ThomasChappe/S63_Arduino/(threads)

Thread 2 (2020-05-14):

S63

ticoraph, 2020-05-14:
Bonjour,
Je souhaiterai faire communiquer/sonner 2 téléphones s63 a cadran. Existe-t-il un vieil intercom qui permettrait de le faire? Pensez-vous que je puisse le faire avec 1 arduino? Merci et bravo pour votre projet.

ThomasChappe, 2020-05-15:
Bonjour,
Un intercom, j'en sais rien, encore faut-il se le procurer et arriver à le faire fonctionner !

Le plus simple avec un "Arduino" c'est de les faire communiquer en wifi, avec des ESP8266, qui sont des petites cartes très proches des Arduino, avec moins de pattes d'entrée/sortie mais avec du Wifi intégré :)

Du coup, avec un bon petit programme en mode client/serveur, ca devrait pouvoir se faire.

Sinon, avec des vrais Arduino, il faudrait un fil entre les deux, et avec une communication en mode "série", c'est possible aussi de les faire sonner l'un / l'autre.

Par contre, c'est relativement loin de ce projet. Je veux dire : la partie MP3 n'a plus d'intérêt et toute la gestion de la communication entre 2 téléphones n'est pas prévue dans ce programme.

Bonne continuation dans votre projet !

jojo-monk, 2020-12-18:
Bonjour,
Il y a quelques temps j'avais réalisé un petit lecteur MP3 piloté par s63 : [https://youtu.be/zMIlXWc8FFQ](url) j'avais aussi utilisé le site revolunet pour m'aider. A l'époque j'avais utilisé un raspberry pi0 malheureusement, le rpi0 (sans doute à cause de la chaleur) s'éteignait tout seul au bout d'un certain temps, de plus il met du temps à démarrer. J'aimerais améliorer mon projet en utilisant un arduino et un lecteur mp3 série comme celui-ci : [https://www.lextronic.fr/grove-lecteur-mp3-v3-107020069-56926.html](url) pour avoir une sortie jack, car je ne compte pas utiliser le haut-parleur du tel, et inclure une alimentation par pile pour le rendre autonome. Pensez-vous que cela soit possible d'adapter votre code avec ce type de matériel ? J'avais programmé en python, à l'époque et je ne connais pas du tout la programmation arduino...

ThomasChappe, 2020-12-19:
Bonjour,

je découvre ce shield MP3, mais à ce que je vois, il suffit de remplacer les appels à la librairie que j'utilise pour mon shiled MP3 par celle du shield, et j'ai bien l'impression que le mode de fonctionnement est assez proche.

Cele ma semble très jouable oui.

Concernant la programmation Arduino, rien de méchant, le code est assez lisible je pense, et c'est proche du C/C++ dans la syntaxe.

Bonne chance pour votre projet !

Clement-39, 2021-03-27:
Bonjour,
Tout d'abord un grand bravo pour votre travail. Je trouve ça génial la façon dont vous avez créé cette machine.

Je rencontre cependant un petit souci, je ne sais pas trop d'où ça vient. Les musiques à l'intérieur des dossiers ne veulent pas se lancer donc cela me renvoi pour toute les années,directement à la sonnerie d'erreur.

Dans chaques dossiers les musiques sont bien nommés : 001.mp3 , 002.mp3 ect..
Savez d'où cela peut venir ?

J'ai remarqué que lorsque que j'introduisais le dossiers MP3 + tous les dossiers années (00,01,02 ect..) dans un même dossier, ça fonctionne et ça trouve la musique. Cependant le dfplayer ne reconnaît plus les pistes dans le dossier MP3.

Ça m'embête car tout le reste à l'air de bien fonctionner.
Avez vous une idée ? Est-ce que cela vien de la carte SD, mes fichiers ne sont pas bien nommés ?
Merci beaucoup.

ThomasChappe, 2021-03-27:
Bonjour,

étrange, j'ai eu plusieurs difficultés avec les cartes SD et le player mais jamais celui-ci.

Cela ne peut pas être un défaut de la carte SD dans votre cas, car sinon, cela ne marcherait jamais.

J'aurais tendance à privilégier un problème de nommage ou d'arborescence.

Le contenu de la carte SD doit avoir une forme de ce type  :
/
  MP3 /
      0001.mp3
      0002.mp3
       ....
  00/
      001.mp3
      002.mp3
      ....
  01/
      001.mp3
      002.mp3
      ....

Si c'est bien ainsi que vous avez mis en place vos dossiers, vérifiez-bien les noms (pas d'espace en trop ?) et si cela ne marche toujours pas, alors c'est que votre player doit avoir un fonctionnement différent et là... il va falloir aller chercher sur le net si vous trouvez de la doc ou des exemples avec votre module spécifique.

A la limite, postez une photo de votre module ?

Clement-39, 2021-03-27:
Merci pour votre réponse !

Effectivement les dossiers sont placés et nommés  exactement comme cela.
J'ai même tenté avec une alimentation 5V externe a l'ordinateur, rien n'y fait.
C'est un dfplayer mini acheté sur Aliexpress, je vais essayé de chercher dans cette direction et trouver la doc.
Je devrais peut-être essayer aussi avec un autre modèle.
Voici la photo en pièce jointe.[Image]

Télécharger Outlook pour Android<https://aka.ms/AAb9ysg>

________________________________
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

ThomasChappe, 2021-03-27:
La doc officielle est là :
https://wiki.dfrobot.com/DFPlayer_Mini_SKU_DFR0299

il y a des exemples de code, et cela permet aussi de tester le module. Probablement un bon moyen d'avancer que de tester ces programmes avec votre module.

Une remarque dans la doc : si jamais vous êtes sur un mac, attention aux fichiers cachés ...

>NOTE: If you are using Mac OS X to copy the mp3,  the file system will automatically add hidden files like: "._0001.mp3"  for index, which this module will handle as valid mp3 files. It is  really annoying. So you can run following command in terminal to  eliminate those files. dot_clean /Volumes/<SDVolumeName> Please replace the  to the volume name of your SD card.

Clement-39, 2023-10-18:
Bonjour Thomas, j'espère que vous me lirez encore. Je me remets dans le code du Socotel et je cherche le moyen d'enchaîner les musiques une à une dans la même année, après qu'on ait écouté la piste en aléatoire de l'année choisie. Et dès qu'on raccroche, fonctionnement normal on recommence en choisissant une autre année. Je ne m'en sors pas avec le code et "g_MP3Player.next();" ou "g_MP3Player.loopFolder();" ne fonctionne pas là où je veux les mettre dans le code. Faut-il ajouter un "void" ou quelque chose de plus simple pourrais fonctionner ?
Mon socotel  fonctionne encore nickel et j'ai ajouter une prise casque. Seul problème récurant le DfPlayer est trop souvent paresseux. 1 fois sur 5 la musique ne se lance pas après avoir passé les deux sonneries, acheminement et attente. Merci d'avance pour ton retour.

ThomasChappe, 2023-11-03:
Hello !

après un petit tour dans la doc (et surtout les exemples), je pense qu'on peut simplement utiliser la fonction "loopFolder"

cf : https://github.com/DFRobot/DFRobotDFPlayerMini/blob/master/examples/FullFunction/FullFunction.ino
et la ligne :  myDFPlayer.loopFolder(5); //loop all mp3 files in folder SD:/05.

A défaut, il faut traquer le code retour du player (readState) et lorsqu'il envoie DFPlayerPlayFinished, enchainer avec le morceau suivant, mais ca va être beaucoup plus compliqué à coder ;)

Pour le lecteur paresseux, j'ai ce problème aussi, de temps en temps mais plutôt lors de la phase de validation de l'année (donc avant l'acheminement et la sonnerie). Je suis en train de voir pour faire du retry sur la lecture, justement à base de lecture du code retour du player... je manque de temps, mais une mise à jour viendra :)

Clement-39, 2023-11-05:
Merci beaucoup pour ton retour, ravi que tu sois encore dans le game dans ce magnifique projet qui sera je pense, encore d'actualité pendant de nombreuses années, voir des décennies !!

Ok pour le "loopFolder" et l'enchaînement avec "readState". Je vais aller dans ce sens et tenter de faire quelque chose. Imaginer un "void PlaySongOneByOne" en incluant ce morceau de code, et en l'ajoutant au "void loop()".

Pour ma part, j'ai l'impression d'avoir rectifié le problème de lecture lors de la phase de validation de l'année, en modifiant dans le "setup", le déclenchement des interruptions "attachInterrupt". En changeant "RINSING" par "CHANGE" (déclenchement de l'interruption à chaque fois que la broche change de valeur). Depuis je n'ai plus de problème, à chaque année le DFPlayer trouve tout le temps le bon dossier, et je pense que le problème venait du calcul des interruptions du cadran. Je me trompe peut-être.

Je soupçonne que mon problème de lecture après "callAndPlaySong", cette à dire après avoir trouvé le dossier et avoir joué "acheminement" puis "sonnerie", vient de la qualité des MP3 téléchargé. J'ai remarqué que certains fichiers MP3, souvent les mêmes, avait du mal à ce lancer. Peut-être ajouter également un deuxième essaie sur le moment : lecture en aléatoire.

A+

dreamnev, 2024-06-05:
Bonjour Thomas,
Pas trouvé d'autre moyen que ce canal pour te remercier chaleureusement de ce partage, je prends mon pied grâce à toi ces dernières semaines et j'ai beaucoup de succès avec mon S63 customisé.
Dans les améliorations apportées, voilà une petite liste :
- adaptation du tout sur un ESP32, il est plus petit dans le téléphone, j'ai le Wifi et plus d'entrées/sorties
- mise en stéréo avec le L et le R de la carte DFPlayer, le L sur le combiné, le R sur l'écouteur, le rendu est génial
- du coup, j'ai mis un HP sur le SPK1 et SPK2, avec un petit interrupteur caché pour l'actionner et trois trous discrets pour laisser le son sortir
- programmation de nombreux numéros spéciaux pour paramétrer le téléphone
- le Wifi m'a permis de me brancher sur un broker MQTT qui envoie des états du téléphone (statut, mode, volume...) mais qui permet aussi de customiser le téléphone : augmenter le volume, changer de mode,
- intégration d'un mode français et un mode international (on passe de l'un à l'autre par MQTT ou numéro spécial)
- intégration d' une base de données des titres et interprètes sous forme d'énorme tableau de constantes, MQTT me permet de les afficher
- je me suis amusé sur les numéros spéciaux (police, renseignements,...), en recréant plein de messages à base de Vivaldi, Beethoven et de Text2 Speech

dans les choses à étudier et à faire :
- faire sonner le téléphone par MQTT, ça peut servir pour ma domotique
- ajouter un écran sur un ESP32 qui reprend les infos du tel et les infos du morceau joué
- intégrer une horloge parlante (le Wifi appelle déjà un serveur NTP), il n'y a plus qu'à coder le tout
- brancher le HP par un transistor et l'allumer ou l'éteindre par une commande par numéro ou MQTT
- appeler un autre téléphone et converser avec lui
- intégrer du bluetooth
- mettre un serveur FTP pour modifier les sons (je suis obligé d'ouvrir le S63 et d'extraire la carte SD à chaque changement)
- passer le tableau des titres/interprètes en base MySql
- ...

Bref, je m'éclate, merci encore pour tout

ThomasChappe, 2024-09-01:
Hello @dreamnev !
(désolé pour le délai de réponse... :-/ )

Ravi que tu t'éclates et merci pour ton message :-)

Tes évolutions sont géniales ! Bravo pour ça ! Tu devrais les publier ! (fork !)

De mon coté, j'en ai un certain nombre dans les cartons, voire déjà réalisées, que j'ai toujours pas fini de tester, donc pas publiées :'(

Parmis elles :
- le mode ESP (évidemment, et le shield qui va avec ;-) )
- l'ajout et le paramétrage de modes et numéros spéciaux (notamment un mode "attire l'attention", ou le téléphone sonne aléatoirement toutes les X minutes)

Parmi celles que j'ai prévu de faire prochainement :
- ton système de pilotage à distance (j'étais plus parti sur du wifi avec une page web de confiq que du MQTT, mais bonne idée !)
- l'ajout de numéros spéciaux pour la domotique (comme toi !) , genre allumer la lumière...
- l'horloge parlante (comme toi)
- voir s'il est possible de monter du SIP et faire un vrai tel en VOIP ?

Certaines de tes autres idées ou réalisations sont incroyables ! Tu devrais clairement forker (ou m'envoyer une pull request !!)
Typiquement, le coup du serveur FTP... ou tout autre système d'upload de sons, c'est un vrai point de blocage pour le moment, et je trouve pas de solution :'(

Au plaisir de te lire, et bonne continuation !

Clement-39, 2024-09-07:
Bonjour,
Bravo Raphaël pour ce travail, ça a l'aire dingue ces améliorations ! Très intéressé aussi si tu décides de partager.
Thomas, je me permets de te poser une question concernant le réglage de la rotation du cadran : anti-rebond sur 10ms et temps d'impulsion sur 20ms initialement. Effectivement le cadran tourne beaucoup mieux avec un peu de WD40 dans la cage, mais avec le temps, il ralentit quand même et ça galère de nouveau sur les impulsions (sonnerie occupée).
J'aimerais faire le bon réglage pour ne plus avoir ce problème, mais j'avoue être un peu largué sur cette histoire d'anti rebond et de réglage de temps d'impulsion, saurais-tu m'en dire plus ?
Merci beaucoup !

ThomasChappe, 2024-09-08:
étrange que le cadran ralentisse régulièrement, sauf si tu en as un usage massif !
Peut-être mettre un lubrifiant plus spécifique à la mécanique que le WD-40 ?

Y'a un truc qui colle pas, en plus : sonnerie occupé ? Ca c'est lorsque tu mets trop longtemps à numéroter tes 4 chiffres. Si c'est un problème avec le cadran, tu devrais avoir la sonnerie "numéro non attribué".

Concernant le rebond et l'impulsion :

-  l'impulsion dure 66ms, et il y a une impulsion toutes les 100ms. Donc si tu fais un "3", tu vas avoir : 66ms de signal haut, 33ms de signal bas, puis 66 ms de signal haut, 33ms de signal bas, et enfin 66ms de signal haut et 33ms de signal bas.
  -Donc donner 20ms de temps supplémentaire à l'impulsion, c'est pour permettre de d'avoir un peu de délai (de marge) si jamais le cadran est un peu "lent" et éviter de compter une 2e impulsion alors qu'il est juste en train de finir la première. C'est comme si les impulsions duraient 86ms max.

- le rebond : c'est un problème mécanique standard. On a ca sur tous les interrupteurs. Lorsque tu appuies sur un bouton (ici, lorsqu'on commence à tourner le cadran) le contact n'est pas instantanément haut. Il y a comme de petits "courts circuits", le contact est pas franc, l'état change très rapidement pendant que le contact se fait. Mais l'Arduino est capable de détecter ca, et donc si on se contente de dire "lorsque tu vois un changement d'état, tu as le cadran qui tourne", il va détecter plein de changement d'état du cadran (tourne, tourne pas... ).
  - donc dire qu'on a un anti rebond de 10ms (et le code qui va avec), ca permet de dire qu'on ne va identifier un changement d'état du cadran que si sont état n'a pas bougé pendant 10ms.

Voilà tu sais tout :)

Et pour t'aider : dans les dernières versions de mon code (après avoir testé plusieurs téléphones), j'ai changé ces deux paramètres.

Désormais je mets 10ms pour le temps d'impulsion bonus, et 20ms pour le debounce

essaie :)

Clement-39, 2024-09-09:
Merci beaucoup, c'est bien plus clair. Je parlais bien de la sonnerie "non attribuée". Je vais utiliser un lubrifiant plus spécifique alors, que le WD40, essayer avec 10ms de temps d'impulsion et 20ms d'anti-rebond et rechanger l'interruption "attachInterrupt(..) par "RISING" car pour ma part, je trouvais que ça fonctionnait mieux avec "CHANGE".

Je voulais vous partager aussi une petite amélioration dont je suis très content et qui fonctionne super : à la fin d'une musique, si l'on ne raccroche pas, le téléphone continue à rejouer une musique aléatoire dans le dossier, indéfiniment. J'ai utilisé la broche BUSY du DFPlayer, qui est à l'état "haut" quand une piste est en lecture, et à l'état "bas" quand le DFPlayer ne lit plus rien. Si "BUSY" est "bas" pendant plus de 3 sec, alors on recherche à nouveau dans le bon dossier et on lit une musique aléatoire. Cela corrige aussi le souci de lecture du DFPlayer paresseux, qui tu avais corrigé par un second essaie. Là, s'il est vraiment paresseux, ce qui m'arrivait de temps en temps, et que rien ne se passe pendant plus de 3 sec, ça recommence de cette manière.

++

Clément

Jacques-F, 2024-10-21:
Bonjour,
Dans les points restant ouverts, il a cette question, peut-être résolue à l'heure actuelle :
_"trouver à quoi sert le 4e fil du cadran"_
Son rôle est de shunter la sonnerie pour éviter les tintements de celle-ci lors de la numérotation. La sonnerie est alimentée normalement par du 80v alternatif envoyé par le central (c'était du 110v dans les premiers centraux). Le ceondensateur en entrée bloque le 48v continu fourni par la ligne et laisse passer le courant d'appel. Lors de la numérotation, l'ouverture/fermeture de la ligne par le cadran passe le condensateur et fait tinter la sonnerie. Le shunt permet d'éviter ça. Celui-ci est d'ailleurs déporté au niveau du conjoncteur par le fil rouge (borne 17 sur le S63 de mémoire).
Voilà un point de résolu.
Jacques

ThomasChappe, 2024-10-21:
whaaa !

Merci beaucoup !
Je mets à jour la page avec ces infos !

guigro, 2024-11-27:
Bonjour à tous,

Merci Thomas pour ce super projet !! J'en suis à mon troisième modèle réussi et je vais en mettre un dans ma future boutique comme jukebox;

Je suis plus que partant pour une version ESP32 avec le shield ! Ce serait vraiment une folie ce que vous annoncez.

Là je bloque sur deux téléphones qui ne veulent rien entendre, ou plutôt rien dire !
Dans le Serial Monitor tout fonctionne, il capte bien le décroché, ne donne pas de tonalité, attend une année qu'il n'enregistre pas, et puis rien d'autre. Je viens de remplacer les DF Player et testé mes soudures, ça ne vient pas de là (ni de la carte SD...). Je continue mon enquête !

Merci encore pour ce super projet !

ThomasChappe, 2024-12-01:
Merci pour le feedback :)

Sur le pb rencontré, je vote : mauvais branchement (mélange) des fils connectés à l'Arduino. Pas branché sur les bonnes pattes.

dreamnev, 2024-12-01:
Bonjour à tous,
Je suis vos avancées de loin, désolé, j'ai d'autres préoccupations. Mais promis, je reviens vers vous prochainement, particulièrement vers toi Thomas.
Pour le problème de guigro, je me suis fait avoir par un double problème : mélange de branchements sur l'ESP comme le suggère Thomas, mais aussi "faux" DF Players, j'ai acheté des versions soi-disant compatibles mais qui montraient des limites. Je m'en suis rendu compte en mettant des traces partout sous forme de serial.println (attention, on est vite débordé si on en met dans une boucle, et l'IDE Arduino ne les supporte pas dans les fonctions d'interruptions, ça fait planter l'exécution sans message :-( ) . J'ai essayé de faire marcher le "faux" DF Player de manière simple, et c'est là que j'ai vu qu'il ne répondait pas correctement aux instructions.
Bonnes recherches

guigro, 2024-12-01:
Merci pour vos retours !!
Je ne pense pas que ce soit un problème de câblage car j’utilise le shield (version avec solénoïdes mais je ne m’en sers pas).
Ça a très bien fonctionné sur 3 modèles, et la j’ai 3 modèles qui ne veulent rien savoir (pour le moment !).

J’ai remarqué que si je décroche 2-3 fois d’affilée assez rapidement (mais pas trop) j’ai le tone qui se lance et que j’entends bien, mais le cadran ne veut rien capter comme chiffre.

En changeant de cadran « à chaud » (je sais c’est mal) l’arduino capte parfois un chiffre durant le serrage des cosses.

Bref prochaine étape je vais rouvrir un des modèles fonctionnels et vérifier si les branchements sont ok, tester le cadran fonctionnel sur le modèle non fonctionnel, et continuer mon enquête !

En tout cas le 1er que j’ai fait permet à mon fils de 18 mois de découvrir des musiques de toutes les époques et il adore !!
Le deuxième ira dans mon bar de brigands à Nantes (ouverture en 2025, ambiance Austin Power / Cyberpunk).
Le troisième je l’ai offert à mon associé qui est ravi.
Et les deux autres ça sera des cadeaux de Noël !!
