ThomasChappe/S63_Arduino/(commit log)

2019-12-29 added bells !
    added the ability to have bells ringing (with solenoid)
2019-12-29 solenoid
    this is it.
    courtesy of https://www.aliexpress.com/item/32801392552.html
2019-12-29 added wiring for 2.5.0 and bells
2020-04-24 version 2.1
    added new params for lazy phones or powerfull arduinos :
    - added a debounce for rotaring detection,
    - added an extra time for pulses length, some old phones seems to be slow...
